RISMicroDevices/HADES-SRAM/sim/tb/tb_hades_top.sv

//-----------------------------------------------------------------------------
// HADES-SRAM — SV testbench harness (M5).
// Pin-level protocol here (dual clocks, resets, AXI4-Lite BFM, SRAM port
// drivers/monitors, MIG model wiring); test intent in sim/cpp/hades_sram_tb.cpp
// via DPI-C (expected memory, exact-latency due-cycle queues, accounting).
//
// Build variants (+define+):
//   (none)                 CSR_EN=1, SYNC    TEST=all_csr
//                          (t6,t1,t2,t3,t4,t5,t7,t9,t12,rst,t13b/c/d,t13a)
//   ASYNC                  CSR_EN=1, ASYNC   TEST=all_csr (t7/t13d walk phase)
//   CSR_STATIC             CSR_EN=0, SYNC    TEST=all_static (static,t3,t9)
//   CSR_STATIC+PARAM_OVRD  CSR_EN=0, SYNC, user P_PORT_BASE/SIZE overrides
//   SELFTEST               CSR_EN=1, SYNC + SELFTEST_EN=1, BLK=16
//                          (TEST=selftest on-chip self-test smoke; the engine
//                          is inert in every other TEST — pins pass through)
// Dedicated runs (not in all_*): TEST=t3 +MAINT_STRESS=1 (worst-case
// maintenance alignment), TEST=t14 +RD_LAT_ADD=1500 (bit5 sentinel fault),
// TEST=t8 +DROP_RD_BEAT/+DROP_RD_BEAT2/+SLVERR_RD_BEAT/+SLVERR_WR_BEAT
// (error paths), TEST=ovf +AR_STALL_LEN=8000 (request-FIFO overflow),
// TEST=t10 +T10_PER=n (long regression; +WDOG_MS raises the watchdog),
// TEST=st_full +REF_BLOCK=300 (st variant; 64-port full-load selftest under
// pessimistic maintenance blocking — the A4 board scenario).
//
// Clocks: ui_clk 300 MHz.  SYNC: port_clk derived from ui_clk by integer
// divider (same-source).  ASYNC: independent realtime generator,
// incommensurate 499.983 KHz by default; T7 adds a phase walk (~4.9 deg
// steps) and +-0.5% slow drift.
//-----------------------------------------------------------------------------
`timescale 1ns/1ps
`default_nettype none

module tb_hades_top #(
  parameter int N = 64,   // DUT active ports (regression default)
  parameter int W0 = 32,
  parameter int W1 = 32,
  parameter int W2 = 32,
  parameter int W3 = 32,
  parameter int W4 = 32,
  parameter int W5 = 32,
  parameter int W6 = 32,
  parameter int W7 = 32,
  parameter int W8 = 32,
  parameter int W9 = 32,
  parameter int W10 = 32,
  parameter int W11 = 32,
  parameter int W12 = 32,
  parameter int W13 = 32,
  parameter int W14 = 32,
  parameter int W15 = 32,
  parameter int W16 = 32,
  parameter int W17 = 32,
  parameter int W18 = 32,
  parameter int W19 = 32,
  parameter int W20 = 32,
  parameter int W21 = 32,
  parameter int W22 = 32,
  parameter int W23 = 32,
  parameter int W24 = 32,
  parameter int W25 = 32,
  parameter int W26 = 32,
  parameter int W27 = 32,
  parameter int W28 = 32,
  parameter int W29 = 32,
  parameter int W30 = 32,
  parameter int W31 = 32,
  parameter int W32 = 32,
  parameter int W33 = 32,
  parameter int W34 = 32,
  parameter int W35 = 32,
  parameter int W36 = 32,
  parameter int W37 = 32,
  parameter int W38 = 32,
  parameter int W39 = 32,
  parameter int W40 = 32,
  parameter int W41 = 32,
  parameter int W42 = 32,
  parameter int W43 = 32,
  parameter int W44 = 32,
  parameter int W45 = 32,
  parameter int W46 = 32,
  parameter int W47 = 32,
  parameter int W48 = 32,
  parameter int W49 = 32,
  parameter int W50 = 32,
  parameter int W51 = 32,
  parameter int W52 = 32,
  parameter int W53 = 32,
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
      53: return W53;
      54: return W54;
      55: return W55;
      56: return W56;
      57: return W57;
      58: return W58;
      59: return W59;
      60: return W60;
      61: return W61;
      62: return W62;
      63: return W63;
      default: return 32;
    endcase
  endfunction

  function automatic int be_of(input int p);
    case (p)
      0: return BE0_EN;
      1: return BE1_EN;
      2: return BE2_EN;
      3: return BE3_EN;
      4: return BE4_EN;
      5: return BE5_EN;
      6: return BE6_EN;
      7: return BE7_EN;
      8: return BE8_EN;
      9: return BE9_EN;
      10: return BE10_EN;
      11: return BE11_EN;
      12: return BE12_EN;
      13: return BE13_EN;
      14: return BE14_EN;
      15: return BE15_EN;
      16: return BE16_EN;
      17: return BE17_EN;
      18: return BE18_EN;
      19: return BE19_EN;
      20: return BE20_EN;
      21: return BE21_EN;
      22: return BE22_EN;
      23: return BE23_EN;
      24: return BE24_EN;
      25: return BE25_EN;
      26: return BE26_EN;
      27: return BE27_EN;
      28: return BE28_EN;
      29: return BE29_EN;
      30: return BE30_EN;
      31: return BE31_EN;
      32: return BE32_EN;
      33: return BE33_EN;
      34: return BE34_EN;
      35: return BE35_EN;
      36: return BE36_EN;
      37: return BE37_EN;
      38: return BE38_EN;
      39: return BE39_EN;
      40: return BE40_EN;
      41: return BE41_EN;
      42: return BE42_EN;
      43: return BE43_EN;
      44: return BE44_EN;
      45: return BE45_EN;
      46: return BE46_EN;
      47: return BE47_EN;
      48: return BE48_EN;
      49: return BE49_EN;
      50: return BE50_EN;
      51: return BE51_EN;
      52: return BE52_EN;
      53: return BE53_EN;
      54: return BE54_EN;
      55: return BE55_EN;
      56: return BE56_EN;
      57: return BE57_EN;
      58: return BE58_EN;
      59: return BE59_EN;
      60: return BE60_EN;
      61: return BE61_EN;
      62: return BE62_EN;
      63: return BE63_EN;
      default: return 0;
    endcase
  endfunction

  localparam logic [BASE_W-1:0] OVRD_BASE3 = 34'h1_2345_0000;
  localparam logic [31:0]       OVRD_SIZE3 = 32'h0002_0000;
  localparam logic [BASE_W-1:0] OVRD_BASE5 = 34'h0_ABCD_0000;

  function automatic logic [N_MAX*BASE_W-1:0] tb_base_flat();
    logic [N_MAX*BASE_W-1:0] v;
    v = dflt_base_flat();
`ifdef PARAM_OVRD
    v[3*BASE_W +: BASE_W] = OVRD_BASE3;
    v[5*BASE_W +: BASE_W] = OVRD_BASE5;
`endif
    return v;
  endfunction

  function automatic logic [N_MAX*32-1:0] tb_size_flat();
    logic [N_MAX*32-1:0] v;
    v = dflt_size_flat(DW_DEFAULT);
`ifdef PARAM_OVRD
    v[3*32 +: 32] = OVRD_SIZE3;
`endif
    return v;
  endfunction

  // ------------------------------------------------------------------
  // Clocks
  // ------------------------------------------------------------------
  logic ui_clk = 1'b0;
  always #(1.6666667) ui_clk = ~ui_clk;   // 300 MHz

  bit   pc_run = 1'b1;
  logic port_clk = 1'b0;

  // current gear's base half period (ns); used by the T7 phase walk/drift
  realtime gear_half_ns;
  initial gear_half_ns = 1000.034;   // 500 KHz gear (also SYNC divider base)

`ifdef ASYNC
  // independent incommensurate source: 499.983 KHz (period 2000.068 ns).
  // T7 phase walk: pc_shift_ns is a one-shot phase nudge (<= 5 deg of the
  // period per step) applied to the next half period; drift walks pc_half_ns
  // around gear_half_ns within +-0.5%.
  realtime pc_half_ns;
  realtime pc_shift_ns = 0.0;
  initial pc_half_ns = 1000.034;
  always begin : g_pclk
    realtime h;
    h = pc_half_ns + pc_shift_ns;
    pc_shift_ns = 0.0;
    #(h);
    if (pc_run) port_clk = ~port_clk;
  end
  task automatic port_clk_set_khz(input int khz);
    gear_half_ns = 500000.0 / khz;
    pc_half_ns   = gear_half_ns;
  endtask

  bit      phase_walk_en = 1'b0;
  realtime drift         = 0.0;
  int      drift_dir     = 1;
  always begin : g_walk
    repeat (3) @(posedge port_clk);
    if (phase_walk_en) begin
      pc_shift_ns = gear_half_ns * 0.049;   // ~4.9 deg step (<= 5 deg)
      if (drift_dir) drift = drift + 0.0004; else drift = drift - 0.0004;
      if (drift >  0.005) begin drift =  0.005; drift_dir = 0; end
      if (drift < -0.005) begin drift = -0.005; drift_dir = 1; end
      pc_half_ns = gear_half_ns * (1.0 + drift);
    end
  end
`else
  // SYNC: integer divider from ui_clk (same-source, like an MMCM output)
  int pc_div = 600;      // ui cycles per port period; 600 => 500 KHz
  int pc_cnt = 0;
  always @(posedge ui_clk) begin
    if (!pc_run) begin
      pc_cnt   <= 0;
      port_clk <= 1'b0;
    end else if (pc_cnt >= pc_div/2 - 1) begin
      pc_cnt   <= 0;
      port_clk <= ~port_clk;
    end else begin
      pc_cnt   <= pc_cnt + 1;
    end
  end
  task automatic port_clk_set_khz(input int khz);
    pc_div       = 300_000 / khz;
    gear_half_ns = 500000.0 / khz;
  endtask
`endif

  task automatic port_clk_stop();  begin pc_run = 1'b0; port_clk = 1'b0; end endtask
  task automatic port_clk_start(); begin pc_run = 1'b1; end endtask

  logic ui_rst_n   = 1'b0;
  logic port_rst_n = 1'b0;
  logic calib_done = 1'b0;

  // ------------------------------------------------------------------
  // DUT <-> MIG model wiring
  // ------------------------------------------------------------------
  // TB-internal packed views (runtime-indexable); the boundary assigns
  // below map them onto the DUT's flat per-port signals (v1.1.0)
  logic [N_MAX-1:0]                t_en    = '0;
  logic [N_MAX-1:0]                t_we    = '0;
  logic [N_MAX-1:0][AW_DEFAULT-1:0] t_addr  = '0;
  logic [N_MAX-1:0][511:0]         t_wdata = '0;
  logic [N_MAX-1:0][63:0]          t_be    = '1;
  logic [N_MAX-1:0][511:0]         t_rdata;
  logic [N_MAX-1:0]                t_rvalid;

  logic [15:0] s_axil_awaddr = 16'd0;
  logic        s_axil_awvalid = 1'b0;
  logic        s_axil_awready;
  logic [31:0] s_axil_wdata = 32'd0;
  logic [3:0]  s_axil_wstrb = 4'h0;
  logic        s_axil_wvalid = 1'b0;
  logic        s_axil_wready;
  logic [1:0]  s_axil_bresp;
  logic        s_axil_bvalid;
  logic        s_axil_bready = 1'b0;
  logic [15:0] s_axil_araddr = 16'd0;
  logic        s_axil_arvalid = 1'b0;
  logic        s_axil_arready;
  logic [31:0] s_axil_rdata;
  logic [1:0]  s_axil_rresp;
  logic        s_axil_rvalid;
  logic        s_axil_rready = 1'b0;

  logic        stat_calib_done, stat_ready, stat_refresh_active, stat_zq_active;
  logic [7:0]  stat_err;

  // DUT <-> model maintenance handshake
  logic        ref_req, ref_ack, zq_req, zq_ack;

  // pin-level backdoor (used in CSR_STATIC builds; tied off otherwise)
  logic                      bkp_req_t = 1'b0, bkp_we_t = 1'b0;
  logic [7:0]                bkp_port_t = 8'd0;
  logic [BASE_W-1:0]         bkp_addr_t = '0;
  logic [DW_DEFAULT-1:0]     bkp_wdata_t = '0;
  logic [DW_DEFAULT-1:0]     bkp_rdata_t;
  logic                      bkp_ack_t;

  // T14: set while fault-injected late responses are expected; gates the
  // rdata X/mismatch checks (rvalid must still assert on schedule)
  bit expect_sentinel = 1'b0;

  // DUT AXI4 master <-> model slave
  logic [3:0]         axi_awid;
  logic [AXI_ADDR_W-1:0] axi_awaddr;
  logic [7:0]         axi_awlen;
  logic [2:0]         axi_awsize;
  logic [1:0]         axi_awburst;
  logic               axi_awvalid, axi_awready;
  logic [511:0]       axi_wdata;
  logic [63:0]        axi_wstrb;
  logic               axi_wlast, axi_wvalid, axi_wready;
  logic [3:0]         axi_bid;
  logic [1:0]         axi_bresp;
  logic               axi_bvalid, axi_bready;
  logic [3:0]         axi_arid;
  logic [AXI_ADDR_W-1:0] axi_araddr;
  logic [7:0]         axi_arlen;
  logic [2:0]         axi_arsize;
  logic [1:0]         axi_arburst;
  logic               axi_arvalid, axi_arready;
  logic [3:0]         axi_rid;
  logic [511:0]       axi_rdata;
  logic [1:0]         axi_rresp;
  logic               axi_rlast, axi_rvalid, axi_rready;

  logic ui_rst;

  // flat per-port DUT signal declarations (v1.1.0)
  logic sram0_en, sram0_we;
  logic [AW_DEFAULT-1:0] sram0_addr;
  logic [W0-1:0] sram0_wdata;
  logic [63:0] sram0_be;
  logic [W0-1:0] sram0_rdata;
  logic sram0_rvalid;
  logic sram1_en, sram1_we;
  logic [AW_DEFAULT-1:0] sram1_addr;
  logic [W1-1:0] sram1_wdata;
  logic [63:0] sram1_be;
  logic [W1-1:0] sram1_rdata;
  logic sram1_rvalid;
  logic sram2_en, sram2_we;
  logic [AW_DEFAULT-1:0] sram2_addr;
  logic [W2-1:0] sram2_wdata;
  logic [63:0] sram2_be;
  logic [W2-1:0] sram2_rdata;
  logic sram2_rvalid;
  logic sram3_en, sram3_we;
  logic [AW_DEFAULT-1:0] sram3_addr;
  logic [W3-1:0] sram3_wdata;
  logic [63:0] sram3_be;
  logic [W3-1:0] sram3_rdata;
  logic sram3_rvalid;
  logic sram4_en, sram4_we;
  logic [AW_DEFAULT-1:0] sram4_addr;
  logic [W4-1:0] sram4_wdata;
  logic [63:0] sram4_be;
  logic [W4-1:0] sram4_rdata;
  logic sram4_rvalid;
  logic sram5_en, sram5_we;
  logic [AW_DEFAULT-1:0] sram5_addr;
  logic [W5-1:0] sram5_wdata;
  logic [63:0] sram5_be;
  logic [W5-1:0] sram5_rdata;
  logic sram5_rvalid;
  logic sram6_en, sram6_we;
  logic [AW_DEFAULT-1:0] sram6_addr;
  logic [W6-1:0] sram6_wdata;
  logic [63:0] sram6_be;
  logic [W6-1:0] sram6_rdata;
  logic sram6_rvalid;
  logic sram7_en, sram7_we;
  logic [AW_DEFAULT-1:0] sram7_addr;
  logic [W7-1:0] sram7_wdata;
  logic [63:0] sram7_be;
  logic [W7-1:0] sram7_rdata;
  logic sram7_rvalid;
  logic sram8_en, sram8_we;
  logic [AW_DEFAULT-1:0] sram8_addr;
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
    .sram51_be     (sram51_be),
    .sram51_rdata  (sram51_rdata),
    .sram51_rvalid (sram51_rvalid),
    .sram52_en     (sram52_en),
    .sram52_we     (sram52_we),
    .sram52_addr   (sram52_addr),
    .sram52_wdata  (sram52_wdata),
    .sram52_be     (sram52_be),
    .sram52_rdata  (sram52_rdata),
    .sram52_rvalid (sram52_rvalid),
    .sram53_en     (sram53_en),
    .sram53_we     (sram53_we),
    .sram53_addr   (sram53_addr),
    .sram53_wdata  (sram53_wdata),
    .sram53_be     (sram53_be),
    .sram53_rdata  (sram53_rdata),
    .sram53_rvalid (sram53_rvalid),
    .sram54_en     (sram54_en),
    .sram54_we     (sram54_we),
    .sram54_addr   (sram54_addr),
    .sram54_wdata  (sram54_wdata),
    .sram54_be     (sram54_be),
    .sram54_rdata  (sram54_rdata),
    .sram54_rvalid (sram54_rvalid),
    .sram55_en     (sram55_en),
    .sram55_we     (sram55_we),
    .sram55_addr   (sram55_addr),
    .sram55_wdata  (sram55_wdata),
    .sram55_be     (sram55_be),
    .sram55_rdata  (sram55_rdata),
    .sram55_rvalid (sram55_rvalid),
    .sram56_en     (sram56_en),
    .sram56_we     (sram56_we),
    .sram56_addr   (sram56_addr),
    .sram56_wdata  (sram56_wdata),
    .sram56_be     (sram56_be),
    .sram56_rdata  (sram56_rdata),
    .sram56_rvalid (sram56_rvalid),
    .sram57_en     (sram57_en),
    .sram57_we     (sram57_we),
    .sram57_addr   (sram57_addr),
    .sram57_wdata  (sram57_wdata),
    .sram57_be     (sram57_be),
    .sram57_rdata  (sram57_rdata),
    .sram57_rvalid (sram57_rvalid),
    .sram58_en     (sram58_en),
    .sram58_we     (sram58_we),
    .sram58_addr   (sram58_addr),
    .sram58_wdata  (sram58_wdata),
    .sram58_be     (sram58_be),
    .sram58_rdata  (sram58_rdata),
    .sram58_rvalid (sram58_rvalid),
    .sram59_en     (sram59_en),
    .sram59_we     (sram59_we),
    .sram59_addr   (sram59_addr),
    .sram59_wdata  (sram59_wdata),
    .sram59_be     (sram59_be),
    .sram59_rdata  (sram59_rdata),
    .sram59_rvalid (sram59_rvalid),
    .sram60_en     (sram60_en),
    .sram60_we     (sram60_we),
    .sram60_addr   (sram60_addr),
    .sram60_wdata  (sram60_wdata),
    .sram60_be     (sram60_be),
    .sram60_rdata  (sram60_rdata),
    .sram60_rvalid (sram60_rvalid),
    .sram61_en     (sram61_en),
    .sram61_we     (sram61_we),
    .sram61_addr   (sram61_addr),
    .sram61_wdata  (sram61_wdata),
    .sram61_be     (sram61_be),
    .sram61_rdata  (sram61_rdata),
    .sram61_rvalid (sram61_rvalid),
    .sram62_en     (sram62_en),
    .sram62_we     (sram62_we),
    .sram62_addr   (sram62_addr),
    .sram62_wdata  (sram62_wdata),
    .sram62_be     (sram62_be),
    .sram62_rdata  (sram62_rdata),
    .sram62_rvalid (sram62_rvalid),
    .sram63_en     (sram63_en),
    .sram63_we     (sram63_we),
    .sram63_addr   (sram63_addr),
    .sram63_wdata  (sram63_wdata),
    .sram63_be     (sram63_be),
    .sram63_rdata  (sram63_rdata),
    .sram63_rvalid (sram63_rvalid),

    .m_axi_awid     (axi_awid),
    .m_axi_awaddr   (axi_awaddr),
    .m_axi_awlen    (axi_awlen),
    .m_axi_awsize   (axi_awsize),
    .m_axi_awburst  (axi_awburst),
    .m_axi_awvalid  (axi_awvalid),
    .m_axi_awready  (axi_awready),
    .m_axi_wdata    (axi_wdata),
    .m_axi_wstrb    (axi_wstrb),
    .m_axi_wlast    (axi_wlast),
    .m_axi_wvalid   (axi_wvalid),
    .m_axi_wready   (axi_wready),
    .m_axi_bid      (axi_bid),
    .m_axi_bresp    (axi_bresp),
    .m_axi_bvalid   (axi_bvalid),
    .m_axi_bready   (axi_bready),
    .m_axi_arid     (axi_arid),
    .m_axi_araddr   (axi_araddr),
    .m_axi_arlen    (axi_arlen),
    .m_axi_arsize   (axi_arsize),
    .m_axi_arburst  (axi_arburst),
    .m_axi_arvalid  (axi_arvalid),
    .m_axi_arready  (axi_arready),
    .m_axi_rid      (axi_rid),
    .m_axi_rdata    (axi_rdata),
    .m_axi_rresp    (axi_rresp),
    .m_axi_rlast    (axi_rlast),
    .m_axi_rvalid   (axi_rvalid),
    .m_axi_rready   (axi_rready),
    .app_ref_req    (ref_req),
    .app_ref_ack    (ref_ack),
    .app_zq_req     (zq_req),
    .app_zq_ack     (zq_ack),
    .s_axil_awaddr  (s_axil_awaddr),
    .s_axil_awvalid (s_axil_awvalid),
    .s_axil_awready (s_axil_awready),
    .s_axil_wdata   (s_axil_wdata),
    .s_axil_wstrb   (s_axil_wstrb),
    .s_axil_wvalid  (s_axil_wvalid),
    .s_axil_wready  (s_axil_wready),
    .s_axil_bresp   (s_axil_bresp),
    .s_axil_bvalid  (s_axil_bvalid),
    .s_axil_bready  (s_axil_bready),
    .s_axil_araddr  (s_axil_araddr),
    .s_axil_arvalid (s_axil_arvalid),
    .s_axil_arready (s_axil_arready),
    .s_axil_rdata   (s_axil_rdata),
    .s_axil_rresp   (s_axil_rresp),
    .s_axil_rvalid  (s_axil_rvalid),
    .s_axil_rready  (s_axil_rready),
    .stat_calib_done    (stat_calib_done),
    .stat_ready         (stat_ready),
    .stat_refresh_active(stat_refresh_active),
    .stat_zq_active     (stat_zq_active),
    .stat_err           (stat_err),
    .bkp_req    (bkp_req_t),
    .bkp_we     (bkp_we_t),
    .bkp_port   (bkp_port_t),
    .bkp_addr   (bkp_addr_t),
    .bkp_wdata  (bkp_wdata_t),
    .bkp_rdata  (bkp_rdata_t),
    .bkp_ack    (bkp_ack_t)
  );

  assign ui_rst = ~ui_rst_n;

  mig_axi4_model u_mig_model (
    .aclk          (ui_clk),
    .arst          (ui_rst),
    .s_axi_awid    (axi_awid),
    .s_axi_awaddr  (axi_awaddr),
    .s_axi_awlen   (axi_awlen),
    .s_axi_awsize  (axi_awsize),
    .s_axi_awburst (axi_awburst),
    .s_axi_awvalid (axi_awvalid),
    .s_axi_awready (axi_awready),
    .s_axi_wdata   (axi_wdata),
    .s_axi_wstrb   (axi_wstrb),
    .s_axi_wlast   (axi_wlast),
    .s_axi_wvalid  (axi_wvalid),
    .s_axi_wready  (axi_wready),
    .s_axi_bid     (axi_bid),
    .s_axi_bresp   (axi_bresp),
    .s_axi_bvalid  (axi_bvalid),
    .s_axi_bready  (axi_bready),
    .s_axi_arid    (axi_arid),
    .s_axi_araddr  (axi_araddr),
    .s_axi_arlen   (axi_arlen),
    .s_axi_arsize  (axi_arsize),
    .s_axi_arburst (axi_arburst),
    .s_axi_arvalid (axi_arvalid),
    .s_axi_arready (axi_arready),
    .s_axi_rid     (axi_rid),
    .s_axi_rdata   (axi_rdata),
    .s_axi_rresp   (axi_rresp),
    .s_axi_rlast   (axi_rlast),
    .s_axi_rvalid  (axi_rvalid),
    .s_axi_rready  (axi_rready),
    .app_ref_req   (ref_req),
    .app_ref_ack   (ref_ack),
    .app_zq_req    (zq_req),
    .app_zq_ack    (zq_ack)
  );

  // ------------------------------------------------------------------
  // DPI-C imports
  // ------------------------------------------------------------------
  import "DPI-C" context function void     hades_init();
  import "DPI-C" context function void     hades_phase_init();
  import "DPI-C" context function void     hades_suspend_checks(int on);
  import "DPI-C" context function longint  hades_exp_id();
  import "DPI-C" context function longint  hades_exp_params(int is_sync, int ui_mhz,
                                                           int port_mib, int dw, int n_max);
  import "DPI-C" context function void     hades_set_port_cfg(int port, longint base, int size);
  import "DPI-C" context function void     hades_set_port_width(int port, int bits);
  import "DPI-C" context function longint  hades_exp_base(int port);
  import "DPI-C" context function int      hades_exp_size(int port);
  import "DPI-C" context function void     hades_mem_write(int port, int addr, bit [511:0] data);
  import "DPI-C" context function void     hades_mem_write_be(int port, int addr, bit [511:0] data, longint be);
  import "DPI-C" context function void     hades_read_expect(int port, longint due_cycle, int addr);
  import "DPI-C" context function void     hades_read_expect0(int port, longint due_cycle);
  import "DPI-C" context function void     hades_read_expect_late(int port, longint due_cycle);
  import "DPI-C" context function void     hades_port_edge(int port, longint cycle,
                                                           int rvalid, bit [511:0] rdata);
  import "DPI-C" context function void     hades_check_eq(string what, longint got, longint exp);
  import "DPI-C" context function void     hades_check_range(string what, longint got,
                                                             longint lo, longint hi);
  import "DPI-C" context function void     hades_fail(string msg);
  import "DPI-C" context function void     hades_log(string msg);
  import "DPI-C" context function int      hades_err_count();
  import "DPI-C" context function void     hades_report();

  // ------------------------------------------------------------------
  // portable PRNG (xorshift32) — identical stimulus on VCS and xsim
  // ------------------------------------------------------------------
  logic [31:0] rng_s = 32'h5EED_1234;

  task automatic rnd(input int unsigned lo, input int unsigned hi,
                     output int unsigned v);
    logic [31:0] x;
    begin
      x = rng_s;
      x ^= x << 13; x ^= x >> 17; x ^= x << 5;
      rng_s = x;
      v = lo + (x % (hi - lo + 1));
    end
  endtask

  // ------------------------------------------------------------------
  // AXI4-Lite master BFM (ui_clk domain)
  // ------------------------------------------------------------------
  task automatic axil_wr(input logic [15:0] a, input logic [31:0] d);
    @(posedge ui_clk);
    s_axil_awaddr  <= a;
    s_axil_awvalid <= 1'b1;
    s_axil_wdata   <= d;
    s_axil_wstrb   <= 4'hF;
    s_axil_wvalid  <= 1'b1;
    forever begin
      @(posedge ui_clk);
      if (s_axil_awready && s_axil_wready) break;
    end
    s_axil_awvalid <= 1'b0;
    s_axil_wvalid  <= 1'b0;
    s_axil_bready  <= 1'b1;
    forever begin
      @(posedge ui_clk);
      if (s_axil_bvalid) break;
    end
    s_axil_bready <= 1'b0;
  endtask

  task automatic axil_rd(input logic [15:0] a, output logic [31:0] d);
    @(posedge ui_clk);
    s_axil_araddr  <= a;
    s_axil_arvalid <= 1'b1;
    s_axil_rready  <= 1'b1;
    forever begin
      @(posedge ui_clk);
      if (s_axil_arready) break;
    end
    s_axil_arvalid <= 1'b0;
    forever begin
      @(posedge ui_clk);
      if (s_axil_rvalid) begin
        d = s_axil_rdata;
        break;
      end
    end
    s_axil_rready <= 1'b0;
  endtask

  // ------------------------------------------------------------------
  // port_clk edge counter + response monitor (exact-latency checking)
  // ------------------------------------------------------------------
  longint pcycle = 0;

  always @(posedge port_clk) begin
    #(0.001);   // 1 ps after the edge: post-NBA sample
    pcycle = pcycle + 1;
    for (int p = 0; p < N_MAX; p++) begin
      if ($isunknown(t_rvalid[p]) ||
          (!expect_sentinel && t_rvalid[p] === 1'b1 && $isunknown(t_rdata[p])))
        hades_fail($sformatf("X on port %0d outputs at pcycle %0d (rvalid=%b rdata=%h)",
                             p, pcycle, t_rvalid[p], t_rdata[p]));
      hades_port_edge(p, pcycle, (t_rvalid[p] === 1'b1) ? 1 : 0,
                      t_rdata[p]);
    end
  end

  // ------------------------------------------------------------------
  // SRAM port drivers (drive at negedge; sampled at next posedge = pcycle+1)
  // ------------------------------------------------------------------
  int cur_lat = 2;   // TB's view of the active L

  task automatic sram_write(input int port, input int addr, input bit [511:0] data);
    @(negedge port_clk);
    t_en[port]    <= 1'b1;
    t_we[port]    <= 1'b1;
    t_addr[port]  <= addr;
    t_wdata[port] <= data;
    hades_mem_write(port, addr, data);
    @(negedge port_clk);
    t_en[port]    <= 1'b0;
  endtask

  // byte-enabled write (v1.1.0): drives t_be with the word (ports with
  // BE<i>_EN=0 ignore it) and merges enabled bytes in the expected model
  task automatic sram_write_be(input int port, input int addr,
                               input bit [511:0] data, input bit [63:0] be);
    @(negedge port_clk);
    t_en[port]    <= 1'b1;
    t_we[port]    <= 1'b1;
    t_addr[port]  <= addr;
    t_wdata[port] <= data;
    t_be[port]    <= be;
    hades_mem_write_be(port, addr, data, be);
    @(negedge port_clk);
    t_en[port]    <= 1'b0;
    t_be[port]    <= '1;
  endtask

  task automatic sram_read(input int port, input int addr);
    @(negedge port_clk);
    t_en[port]    <= 1'b1;
    t_we[port]    <= 1'b0;
    t_addr[port]  <= addr;
    hades_read_expect(port, pcycle + 1 + cur_lat, addr);
    @(negedge port_clk);
    t_en[port]    <= 1'b0;
  endtask

  // fully back-to-back read burst (one read every port period)
  task automatic sram_read_burst(input int port, input int n, input int addr0);
    for (int k = 0; k < n; k++) begin
      @(negedge port_clk);
      t_en[port]   <= 1'b1;
      t_we[port]   <= 1'b0;
      t_addr[port] <= addr0 + k;
      hades_read_expect(port, pcycle + 1 + cur_lat, addr0 + k);
    end
    @(negedge port_clk);
    t_en[port] <= 1'b0;
  endtask

  // fully back-to-back write burst
  task automatic sram_write_burst(input int port, input int n, input int addr0,
                                  input bit [511:0] data0);
    for (int k = 0; k < n; k++) begin
      @(negedge port_clk);
      t_en[port]   <= 1'b1;
      t_we[port]   <= 1'b1;
      t_addr[port] <= addr0 + k;
      t_wdata[port] <= data0 + k;
      hades_mem_write(port, addr0 + k, data0 + k);
    end
    @(negedge port_clk);
    t_en[port] <= 1'b0;
  endtask

  // read to an illegal address: synthetic zero response, still on schedule
  task automatic sram_read_illegal(input int port, input int addr);
    @(negedge port_clk);
    t_en[port]    <= 1'b1;
    t_we[port]    <= 1'b0;
    t_addr[port]  <= addr;
    hades_read_expect0(port, pcycle + 1 + cur_lat);
    @(negedge port_clk);
    t_en[port]    <= 1'b0;
  endtask

  // let all outstanding reads release
  task automatic drain();
    repeat (5) @(negedge port_clk);
  endtask

  // ------------------------------------------------------------------
  // Reset.  Resets must be held for >= 3 port_clk periods: the port domain
  // (FIFOs, shaper) is synchronous to the slow clock, and the afifo's two
  // sides must reset together — a ui-only pulse would corrupt the Gray
  // pointers.  (The CSR SOFT_RESET instead stretches into the port domain
  // by design; see the top level.)  calib_done drops (the TB models the
  // MIG recalibrating across a system reset).
  // ------------------------------------------------------------------
  task automatic do_reset();
    begin
      ui_rst_n   = 1'b0;
      port_rst_n = 1'b0;
      calib_done = 1'b0;
      repeat (3) @(posedge port_clk);
      ui_rst_n   = 1'b1;
      port_rst_n = 1'b1;
      repeat (10) @(posedge ui_clk);
    end
  endtask

  // Default flat address map for all ports.  T6 writes a custom map and T1
  // shrinks PORT_SIZE for error tests — every traffic phase must start from
  // the default flat map.
  task automatic csr_default_map();
    begin
      for (int p = 0; p < N_MAX; p++) begin
        axil_wr(CSR_PORT_SEL, 32'(p));
        axil_wr(CSR_PORT_BASE, 32'(p * 32'h0004_0000));  // i * 2^18 beats
        axil_wr(CSR_PORT_BASE_HI, 32'd0);
        axil_wr(CSR_PORT_SIZE, 32'h0040_0000);           // 16 MiB in DW32 words
      end
    end
  endtask

  // CSR helper: program L and enable mask, wait for ready.
  // The frequency monitor must observe a running, legal port_clk first
  // (spec init sequence: check MEAS_PERIOD before ENABLE; 4-period average
  // is valid after 5 edges).  n_active programs CFG_PORTS (arbiter
  // slot-table extent).
  task automatic csr_enable(input int lat, input longint en_mask,
                            input int n_active = N_MAX);
    logic [31:0] rd;
    begin
      axil_wr(CSR_CTRL, 32'h0);
      axil_wr(CSR_CFG_LATENCY, 32'(lat));
      axil_wr(CSR_PORT_EN_LO, 32'(en_mask));
      axil_wr(CSR_PORT_EN_HI, 32'(en_mask >> 32));
      axil_wr(CSR_CFG_PORTS, 32'(n_active));
      csr_default_map();
      repeat (6) @(posedge port_clk);   // let freq_mon measure the clock
      axil_wr(CSR_CTRL, 32'h1);
      // poll READY: after a SOFT_RESET the port-domain reset stretch gates
      // ENABLE for ~9.4k ui_clk cycles; each poll is ~10 cycles
      for (int t = 0; t < 2500; t++) begin
        axil_rd(CSR_STATUS, rd);
        if ((rd & 32'h3) == 32'h3) break;
      end
      hades_check_eq("STATUS ready after ENABLE", rd & 32'h3, 32'h3);
      cur_lat = lat;
    end
  endtask

  // ------------------------------------------------------------------
  // T6 basic (CSR_EN=1)
  // ------------------------------------------------------------------
  task automatic test_t6_csr();
    logic [31:0] rd;
    longint      b;
    int unsigned s;
    begin
      hades_log("--- T6 basic: CSR flow ---");

      axil_rd(CSR_ID, rd);
      hades_check_eq("ID", rd, hades_exp_id());
      axil_rd(CSR_PARAMS, rd);
      hades_check_eq("PARAMS", rd, hades_exp_params(TB_SYNC ? 1 : 0, UI_CLK_MHZ,
                                                    PORT_MB_DEFAULT, DW_DEFAULT, N_MAX));

      // ENABLE rejected while calib_done=0
      axil_wr(CSR_CTRL, 32'h1);
      axil_rd(CSR_CTRL, rd);
      hades_check_eq("ENABLE reject (no calib)", rd, 0);
      axil_rd(CSR_ERR_STATUS, rd);
      hades_check_eq("ERR_STATUS.bit4 (no calib)", rd, 32'h10);
      axil_wr(CSR_ERR_STATUS, 32'h10);
      axil_rd(CSR_ERR_STATUS, rd);
      hades_check_eq("ERR_STATUS W1C", rd, 0);
      calib_done = 1'b1;
      repeat (4) @(posedge ui_clk);

      // indexed window: program + readback all 64 ports
      for (int p = 0; p < N_MAX; p++) begin
        b = p * 64'h0100_0000 + 64'h0000_4000;
        if (p == 5) b = (64'h2 << 32) | 64'h1234_5678;
        s = 32'h0001_0000 + p;
        hades_set_port_cfg(p, b, s);
        axil_wr(CSR_PORT_SEL, p);
        axil_wr(CSR_PORT_BASE, 32'(b));
        axil_wr(CSR_PORT_BASE_HI, 32'(b >> 32));
        axil_wr(CSR_PORT_SIZE, s);
      end
      for (int p = 0; p < N_MAX; p++) begin
        axil_wr(CSR_PORT_SEL, p);
        axil_rd(CSR_PORT_BASE, rd);
        hades_check_eq($sformatf("PORT_BASE[%0d]", p), rd, hades_exp_base(p) & 64'hFFFF_FFFF);
        axil_rd(CSR_PORT_BASE_HI, rd);
        hades_check_eq($sformatf("PORT_BASE_HI[%0d]", p), rd, (hades_exp_base(p) >> 32) & 64'h3);
        axil_rd(CSR_PORT_SIZE, rd);
        hades_check_eq($sformatf("PORT_SIZE[%0d]", p), rd, hades_exp_size(p) & 64'hFFFF_FFFF);
      end

      // out-of-range PORT_SEL
      axil_wr(CSR_PORT_SEL, 32'd200);
      axil_rd(CSR_PORT_BASE, rd);
      hades_check_eq("PORT_SEL oob read 0", rd, 0);
      axil_wr(CSR_PORT_BASE, 32'hFFFF_FFFF);
      axil_wr(CSR_PORT_SEL, 32'd0);
      axil_rd(CSR_PORT_BASE, rd);
      hades_check_eq("oob write ignored", rd, hades_exp_base(0) & 64'hFFFF_FFFF);

      // CFG_LATENCY legal/illegal
      axil_wr(CSR_CFG_LATENCY, 32'd1);
      axil_rd(CSR_CFG_LATENCY, rd);
      hades_check_eq("CFG_LATENCY=1", rd, 1);
      axil_wr(CSR_CFG_LATENCY, 32'd3);
      axil_rd(CSR_CFG_LATENCY, rd);
      hades_check_eq("CFG_LATENCY illegal ignored", rd, 1);
      axil_wr(CSR_CFG_LATENCY, 32'd2);
      axil_rd(CSR_CFG_LATENCY, rd);
      hades_check_eq("CFG_LATENCY=2", rd, 2);

      axil_wr(CSR_PORT_EN_LO, 32'hDEAD_BEEF);
      axil_rd(CSR_PORT_EN_LO, rd);
      hades_check_eq("PORT_EN_LO", rd, 32'hDEAD_BEEF);
      axil_wr(CSR_PORT_EN_HI, 32'h0BAD_F00D);
      axil_rd(CSR_PORT_EN_HI, rd);
      hades_check_eq("PORT_EN_HI", rd, 32'h0BAD_F00D);
      axil_wr(CSR_CFG_PORTS, 32'd64);
      axil_rd(CSR_CFG_PORTS, rd);
      hades_check_eq("CFG_PORTS", rd, 64);

      // MEAS_PERIOD: SYNC divider => exactly 600; ASYNC => incommensurate
      repeat (6) @(posedge port_clk);
      axil_rd(CSR_MEAS_PERIOD, rd);
`ifdef ASYNC
      hades_check_range("MEAS_PERIOD @~500KHz", rd, 595, 605);
`else
      hades_check_eq("MEAS_PERIOD @500KHz", rd, 600);
`endif

      // ENABLE -> READY; SOFT_RESET
      axil_wr(CSR_CTRL, 32'h1);
      axil_rd(CSR_CTRL, rd);
      hades_check_eq("ENABLE set", rd, 1);
      axil_rd(CSR_STATUS, rd);
      hades_check_eq("STATUS calib+ready", rd, 32'h3);
      axil_wr(CSR_CTRL, 32'h2);
      axil_rd(CSR_CTRL, rd);
      hades_check_eq("SOFT_RESET clears enable", rd, 0);
      axil_rd(CSR_STATUS, rd);
      hades_check_eq("SOFT_RESET ready=0", rd, 32'h1);
      axil_rd(CSR_CFG_PORTS, rd);
      hades_check_eq("config retained", rd, 64);

      // clock stop / restart interlock
      port_clk_stop();
      #60_000;
      axil_wr(CSR_CTRL, 32'h1);
      axil_rd(CSR_CTRL, rd);
      hades_check_eq("ENABLE reject (clk stopped)", rd, 0);
      axil_rd(CSR_ERR_STATUS, rd);
      hades_check_eq("ERR_STATUS.bit4 (clk stopped)", rd, 32'h10);
      axil_wr(CSR_ERR_STATUS, 32'h10);
      port_clk_start();
      #20_000;
      axil_wr(CSR_CTRL, 32'h1);
      axil_rd(CSR_CTRL, rd);
      hades_check_eq("ENABLE after clk restart", rd, 1);
      axil_wr(CSR_CTRL, 32'h0);

      // over-frequency interlock
      port_clk_set_khz(2000);
      #10_000;
      axil_wr(CSR_CTRL, 32'h1);
      axil_rd(CSR_CTRL, rd);
      hades_check_eq("ENABLE reject (over-freq)", rd, 0);
      axil_rd(CSR_ERR_STATUS, rd);
      hades_check_eq("ERR_STATUS.bit4 (over-freq)", rd, 32'h10);
      axil_wr(CSR_ERR_STATUS, 32'h10);
      port_clk_set_khz(500);
      #20_000;
      axil_wr(CSR_CTRL, 32'h1);
      axil_rd(CSR_CTRL, rd);
      hades_check_eq("ENABLE after freq restore", rd, 1);
      axil_wr(CSR_CTRL, 32'h0);
    end
  endtask

  // ------------------------------------------------------------------
  // T1: single-port random read/write, 100% data correctness
  // ------------------------------------------------------------------
  task automatic test_t1(input int n_ops);
    int unsigned addr;
    int unsigned data;
    int unsigned we_u;
    logic [31:0] rd;
    begin
      hades_log($sformatf("--- T1: single-port random R/W, %0d ops ---", n_ops));
      calib_done = 1'b1;
      csr_enable(2, 64'h1);   // port 0, L=2

      for (int k = 0; k < n_ops; k++) begin
        int unsigned gap;
        rnd(0, (1 << 22) - 1, addr);
        rnd(0, 32'hFFFF_FFFF, data);
        rnd(0, 1, we_u);
        if (we_u == 1) sram_write(0, addr, data);
        else           sram_read(0, addr);
        rnd(0, 3, gap);
        if (gap == 0) @(negedge port_clk);   // random idle gap
      end
      drain();

      // illegal-address read: shrink port 0's size, then read beyond it
      // (synthetic zero response on schedule + ERR_STATUS.bit0)
      axil_wr(CSR_PORT_SEL, 32'd0);
      axil_wr(CSR_PORT_SIZE, 32'h0000_1000);
      sram_read_illegal(0, 32'h0000_2000);
      drain();
      axil_rd(CSR_ERR_STATUS, rd);
      hades_check_eq("ERR_STATUS.bit0 (illegal addr)", rd & 32'h1, 32'h1);
      axil_rd(CSR_ERR_ADDR, rd);
      hades_check_eq("ERR_ADDR = port0:0x2000", rd, 32'h0000_2000);
      axil_wr(CSR_ERR_STATUS, 32'h1);   // W1C
      axil_rd(CSR_ERR_STATUS, rd);
      hades_check_eq("ERR_STATUS cleared", rd, 32'h0);

      // per-port stats sanity
      axil_wr(CSR_PORT_SEL, 32'd0);
      axil_rd(CSR_PORT_STAT_ERR, rd);
      hades_check_eq("port0 err count = 1 (illegal)", rd, 1);
      axil_wr(CSR_PORT_STAT_ERR, 32'h1);  // W1C clear
      axil_rd(CSR_PORT_STAT_ERR, rd);
      hades_check_eq("port0 err cleared", rd, 0);

      axil_wr(CSR_PORT_SIZE, 32'h0040_0000);   // restore default 16 MiB
      axil_wr(CSR_CTRL, 32'h0);
    end
  endtask

  // ------------------------------------------------------------------
  // T2: latency exactness — rvalid exactly at request+L port edges.
  // L=2 and L=1, back-to-back bursts and gapped traffic.
  // ------------------------------------------------------------------
  task automatic test_t2();
    begin
      hades_log("--- T2: latency exactness, L=2 and L=1 ---");
      calib_done = 1'b1;

      for (int lat = 2; lat >= 1; lat--) begin
        csr_enable(lat, 64'h3);          // ports 0 and 1
        // seed memory then fully back-to-back burst reads
        sram_write_burst(0, 64, 32'h1000, 32'hA500_0000);
        sram_write_burst(1, 64, 32'h2000, 32'h5A00_0000);
        drain();
        sram_read_burst(0, 64, 32'h1000);
        drain();
        // two ports concurrently: writes then reads, interleaved in time
        fork
          begin
            sram_write_burst(0, 32, 32'h4000, 32'hC000_0000);
            sram_read_burst(0, 32, 32'h4000);
          end
          begin
            sram_write_burst(1, 32, 32'h5000, 32'h0300_0000);
            sram_read_burst(1, 32, 32'h5000);
          end
        join
        drain();
        // RAW: write then read same address on adjacent cycles
        @(negedge port_clk);
        t_en[0] <= 1'b1; t_we[0] <= 1'b1; t_addr[0] <= 32'h777; t_wdata[0] <= 32'hDEAD_1234;
        hades_mem_write(0, 32'h777, 32'hDEAD_1234);
        @(negedge port_clk);
        t_en[0] <= 1'b1; t_we[0] <= 1'b0; t_addr[0] <= 32'h777;
        hades_read_expect(0, pcycle + 1 + cur_lat, 32'h777);
        @(negedge port_clk);
        t_en[0] <= 1'b0;
        drain();
      end
      axil_wr(CSR_CTRL, 32'h0);
    end
  endtask

  // ------------------------------------------------------------------
  // T3: maintenance stress — worst refresh+ZQCS+periodic-read combination,
  // repeating the full T2 content.  Maintenance cadence is shrunk so the
  // window is exercised every target period (refresh due every period,
  // ZQCS every 4 periods); the MAINT_STRESS plusarg additionally forces a
  // PHY periodic read into every refresh window (model side).
  // Determinism proof: ERR_STATUS stays 0 (bit5 sentinel silent) and the
  // refresh rate tracks CFG_REFRESH_DIV (A6 rehearsal).
  // ------------------------------------------------------------------
  task automatic test_t3();
    logic [31:0] rd;
    logic [31:0] refc0, refc1;
    longint      w0, w1;
    begin
      hades_log("--- T3: maintenance stress, T2 content ---");
      calib_done = 1'b1;
`ifdef CSR_STATIC
      // static variant: fixed P_REFRESH_DIV=2100 / P_ZQ_DIV=32000 / L=2
      #10_000;
      fork
        begin
          sram_write_burst(0, 64, 32'h9000, 32'h3C00_0000);
          sram_read_burst(0, 64, 32'h9000);
        end
        begin
          sram_write_burst(1, 64, 32'hA000, 32'hC300_0000);
          sram_read_burst(1, 64, 32'hA000);
        end
      join
      drain();
      hades_check_eq("T3 static: stat_err clean", stat_err, 0);
`else
      axil_wr(CSR_CTRL, 32'h0);
      axil_wr(CSR_CFG_REFRESH_DIV, 32'd600);   // one refresh due per window
      axil_wr(CSR_CFG_ZQ_DIV, 32'd4);          // ZQCS every 4 windows
      test_t2();                               // spec: repeat T2 under stress

      // refresh rate over 100 windows (enabled, no traffic)
      csr_enable(2, 64'h3);
      axil_rd(CSR_STAT_REFCNT, refc0);
      w0 = pcycle;
      repeat (100) @(posedge port_clk);
      axil_rd(CSR_STAT_REFCNT, refc1);
      w1 = pcycle;
      hades_check_range("T3 STAT_REFCNT rate (~1/window)",
                        refc1 - refc0, (w1 - w0) * 95 / 100, (w1 - w0) * 105 / 100 + 2);

      axil_rd(CSR_ERR_STATUS, rd);
      hades_check_eq("T3: ERR_STATUS clean under worst maintenance", rd & 32'h3F, 0);
      axil_wr(CSR_CFG_REFRESH_DIV, 32'd2100);  // restore defaults
      axil_wr(CSR_CFG_ZQ_DIV, 32'd32000);
      axil_wr(CSR_CTRL, 32'h0);
`endif
    end
  endtask

  // ------------------------------------------------------------------
  // T14: response-window sentinel — the model's +RD_LAT_ADD stretches every
  // backend read past the L-cycle contract; each release must still assert
  // rvalid on schedule (data don't-care) and ERR_STATUS.bit5 must set.
  // Dedicated run only (not part of all_csr/all_static).
  // ------------------------------------------------------------------
  task automatic test_t14();
    logic [31:0] rd;
    int unsigned lat_add;
    begin
      hades_log("--- T14: response-window sentinel fault injection ---");
      if (!$value$plusargs("RD_LAT_ADD=%d", lat_add) || lat_add == 0) begin
        hades_log("T14 skipped: needs +RD_LAT_ADD=<n> model stretch");
        return;
      end
      calib_done = 1'b1;
`ifdef CSR_STATIC
      #10_000;   // static auto-enable, P_L=2
      expect_sentinel = 1;
      sram_write(0, 32'h300, 32'h5AFE_0001);
      for (int k = 0; k < 3; k++) begin
        @(negedge port_clk);
        t_en[0] <= 1'b1; t_we[0] <= 1'b0; t_addr[0] <= 32'h300 + k;
        hades_read_expect_late(0, pcycle + 1 + 2);
        @(negedge port_clk);
        t_en[0] <= 1'b0;
        @(negedge port_clk);
      end
      drain();
      expect_sentinel = 0;
      // L=2 + the 768-cycle backend-timeout backstop: the synthetic zero
      // lands before the release edge, so a dead backend surfaces as bit1
      // (timeout), not bit5.  The sentinel is reachable at L=1 (CSR runs).
      hades_check_eq("T14 static: timeout backstop stat_err[1]", stat_err[1], 1);
      hades_check_eq("T14 static: sentinel bit5 stays 0", stat_err[5], 0);
`else
      csr_enable(1, 64'h1);   // L=1: tightest response window
      expect_sentinel = 1;
      sram_write(0, 32'h300, 32'h5AFE_0001);
      for (int k = 0; k < 3; k++) begin
        @(negedge port_clk);
        t_en[0] <= 1'b1; t_we[0] <= 1'b0; t_addr[0] <= 32'h300 + k;
        hades_read_expect_late(0, pcycle + 1 + cur_lat);
        @(negedge port_clk);
        t_en[0] <= 1'b0;
        @(negedge port_clk);
      end
      drain();
      expect_sentinel = 0;
      axil_rd(CSR_ERR_STATUS, rd);
      hades_check_eq("T14: ERR_STATUS.bit5 sentinel set", rd & 32'h20, 32'h20);
      hades_check_eq("T14: first-error port = 0", (rd >> 8) & 32'hFF, 0);
      axil_wr(CSR_ERR_STATUS, 32'h3F);   // W1C all (timeout bit1 also fired)
      axil_rd(CSR_ERR_STATUS, rd);
      hades_check_eq("T14: error bits W1C clear", rd & 32'h3F, 0);
      axil_wr(CSR_CTRL, 32'h0);
`endif
    end
  endtask

  // ------------------------------------------------------------------
  // T8: error paths.  Needs the model fault knobs (+DROP_RD_BEAT /
  //  +SLVERR_RD_BEAT / +SLVERR_WR_BEAT); skipped without them.  Fixed
  //  target addresses, so the beats are known at launch:
  //    timeout    : port 0 word 0x77777 -> beat 0x07777
  //    SLVERR rd  : port 1 word 0x05555 -> beat 0x40555
  //    SLVERR wr  : port 0 word 0x09999 -> beat 0x00999
  //  Criteria: right ERR_STATUS/stat_err bits with the right port, the
  //  faulted access still completes (synthetic zero on schedule for the
  //  timeout, real data with SLVERR status), and traffic continues clean
  //  afterwards (no hang).
  // ------------------------------------------------------------------
  task automatic test_t8();
    logic [31:0] rd;
    longint unsigned kn_drop, kn_slvrd, kn_slvwr, kn_drop2;
    begin
      hades_log("--- T8: error paths (illegal / timeout / SLVERR) ---");
      if (!($value$plusargs("DROP_RD_BEAT=%h", kn_drop)
            && $value$plusargs("DROP_RD_BEAT2=%h", kn_drop2)
            && $value$plusargs("SLVERR_RD_BEAT=%h", kn_slvrd)
            && $value$plusargs("SLVERR_WR_BEAT=%h", kn_slvwr))) begin
        hades_log("T8 skipped: needs +DROP_RD_BEAT/+DROP_RD_BEAT2/+SLVERR_RD_BEAT/+SLVERR_WR_BEAT");
        return;
      end
      calib_done = 1'b1;
`ifdef CSR_STATIC
      #10_000;   // auto-enable (P_L=2)
      cur_lat = 2;
`ifdef PARAM_OVRD
      // illegal: port 3 is shrunk to 128 KiW by the override — read beyond
      // it.  (In the plain static map every 22-bit address is legal by
      // construction, so bit0 is exercised here and in the CSR variants.)
      @(negedge port_clk);
      t_en[3] <= 1'b1; t_we[3] <= 1'b0; t_addr[3] <= 32'h0002_0000;
      hades_read_expect0(3, pcycle + 1 + cur_lat);
      @(negedge port_clk);
      t_en[3] <= 1'b0;
      drain();
`endif
      // timeout: the dropped read completes as scheduled zeros
      @(negedge port_clk);
      t_en[0] <= 1'b1; t_we[0] <= 1'b0; t_addr[0] <= 32'h0007_7777;
      hades_read_expect0(0, pcycle + 1 + cur_lat);
      @(negedge port_clk);
      t_en[0] <= 1'b0;
      drain();
      // SLVERR read (real data + error flag) and SLVERR write (applied,
      // then flagged on B)
      sram_write(1, 32'h5555, 32'hABCD_0001);
      drain();
      sram_read(1, 32'h5555);
      sram_write(0, 32'h9999, 32'h0BAD_0BAD);
      drain();
      sram_read(0, 32'h9999);   // written data survives the SLVERR flag
      drain();
`ifdef PARAM_OVRD
      hades_check_eq("T8 static: stat_err bits 0/1/3", stat_err, 8'h0B);
`else
      // plain static map: bit0 unreachable (every 22-bit address legal)
      hades_check_eq("T8 static: stat_err bits 1/3", stat_err, 8'h0A);
`endif
      // no hang: clean burst afterwards (scoreboard validates)
      sram_write_burst(0, 32, 32'h4000, 32'h1234_0000);
      sram_read_burst(0, 32, 32'h4000);
      drain();
`else
      csr_enable(2, 64'hF, 4);

      // (1) backdoor read of the drop2 beat: the backend timeout completes
      // it with zeros; bit1 sets with the backdoor marker port 0xFF (done
      // FIRST so the first-error latch is clean)
      begin
        logic [31:0] bst, bd;
        bkp_rd(3, 32'h0000_ACE0, bd, bst);
        hades_check_eq("T8: bkp timeout completes err-free", bst & 32'h7, 32'h2);
        hades_check_eq("T8: bkp timeout data = 0", bd, 0);
      end
      axil_rd(CSR_ERR_STATUS, rd);
      hades_check_eq("T8: bit1 set (backdoor timeout)", (rd >> 1) & 32'h1, 32'h1);
      hades_check_eq("T8: backdoor timeout port = 0xFF", (rd >> 8) & 32'hFF, 32'hFF);

      // (2) illegal read: shrink port 0, read beyond it (synthetic zero).
      // bit0 now sets ALONGSIDE bit1 -> first-error info must not change
      axil_wr(CSR_PORT_SEL, 32'd0);
      axil_wr(CSR_PORT_SIZE, 32'h0000_1000);
      sram_read_illegal(0, 32'h0000_2000);
      drain();
      axil_rd(CSR_ERR_STATUS, rd);
      hades_check_eq("T8: bit0 illegal set", rd & 32'h1, 32'h1);
      hades_check_eq("T8: first-error port stays 0xFF", (rd >> 8) & 32'hFF, 32'hFF);

      // (2b) illegal WRITE: discarded silently (posted), same bit0
      @(negedge port_clk);
      t_en[0] <= 1'b1; t_we[0] <= 1'b1; t_addr[0] <= 32'h0000_2000;
      t_wdata[0] <= 32'hBAD5_0000;
      @(negedge port_clk);
      t_en[0] <= 1'b0;
      drain();

      // partial W1C: bits 0+1 set; clearing only bit0 must leave bit1
      axil_wr(CSR_ERR_STATUS, 32'h1);
      axil_rd(CSR_ERR_STATUS, rd);
      hades_check_eq("T8: partial W1C keeps bit1", rd & 32'h3, 32'h2);
      axil_wr(CSR_ERR_STATUS, 32'h3F);
      csr_default_map();                  // restore port 0 size

      // (3) backend timeout on a port: the dropped read completes as
      // scheduled zeros (timeout 768 < L=2 release at 1200 -> no sentinel)
      sram_write(0, 32'h0007_7777, 32'h1234_5678);
      @(negedge port_clk);
      t_en[0] <= 1'b1; t_we[0] <= 1'b0; t_addr[0] <= 32'h0007_7777;
      hades_read_expect0(0, pcycle + 1 + cur_lat);
      @(negedge port_clk);
      t_en[0] <= 1'b0;
      drain();
      axil_rd(CSR_ERR_STATUS, rd);
      hades_check_eq("T8: bit1 timeout set", (rd >> 1) & 32'h1, 32'h1);
      hades_check_eq("T8: timeout port = 0", (rd >> 8) & 32'hFF, 0);
      axil_wr(CSR_ERR_STATUS, 32'h3F);

      // (4) SLVERR read: real data returned, bit3 flagged, port 1
      sram_write(1, 32'h5555, 32'hABCD_0001);
      drain();
      sram_read(1, 32'h5555);
      drain();
      // (5) SLVERR write: applied to memory, flagged on B; readback clean
      sram_write(0, 32'h9999, 32'h0BAD_0BAD);
      drain();
      sram_read(0, 32'h9999);
      drain();
      axil_rd(CSR_ERR_STATUS, rd);
      hades_check_eq("T8: bit3 SLVERR set", (rd >> 3) & 32'h1, 32'h1);
      axil_wr(CSR_ERR_STATUS, 32'h3F);

      // (6) no hang: clean burst traffic, no residual errors
      sram_write_burst(0, 32, 32'h4000, 32'h1234_0000);
      sram_read_burst(0, 32, 32'h4000);
      drain();
      axil_rd(CSR_ERR_STATUS, rd);
      hades_check_eq("T8: clean after faults", rd & 32'h3F, 0);
      axil_wr(CSR_CTRL, 32'h0);
`endif
    end
  endtask

`ifndef CSR_STATIC
  // ------------------------------------------------------------------
  // OVF: port request-FIFO overflow (ERR_STATUS.bit2, the "dropped request"
  // sentinel).  With the model's AR channel stalled (+AR_STALL_LEN), a
  // back-to-back read burst overruns the depth-8 request FIFO.  All reads
  // still release on schedule (sentinel fires too — fault expected); the
  // documented recovery is SOFT_RESET, verified with clean traffic after.
  // Dedicated run only (not part of all_csr).
  // ------------------------------------------------------------------
  task automatic test_ovf();
    logic [31:0] rd;
    int unsigned stall_len;
    begin
      hades_log("--- OVF: port request-FIFO overflow (bit2) ---");
      if (!$value$plusargs("AR_STALL_LEN=%d", stall_len) || stall_len < 8000) begin
        hades_log("OVF skipped: needs +AR_STALL_LEN>=8000");
        return;
      end
      calib_done = 1'b1;
      csr_enable(1, 64'h1, 1);
      for (int k = 0; k < 12; k++) begin
        @(negedge port_clk);
        t_en[0] <= 1'b1; t_we[0] <= 1'b0; t_addr[0] <= 32'h800 + 32'(k);
        hades_read_expect_late(0, pcycle + 1 + cur_lat);  // data don't-care
      end
      @(negedge port_clk);
      t_en[0] <= 1'b0;
      drain();
      axil_rd(CSR_ERR_STATUS, rd);
      hades_check_eq("OVF: bit2 dropped-request set", (rd >> 2) & 32'h1, 32'h1);
      // documented recovery: SOFT_RESET, re-init, clean traffic
      axil_wr(CSR_CTRL, 32'h2);
      repeat (20) @(posedge port_clk);
      csr_enable(1, 64'h1, 1);
      sram_write_burst(0, 16, 32'h9000, 32'hCAFE_1000);
      sram_read_burst(0, 16, 32'h9000);
      drain();
      axil_rd(CSR_ERR_STATUS, rd);
      hades_check_eq("OVF: clean after SOFT_RESET", rd & 32'h3F, 0);
      axil_wr(CSR_CTRL, 32'h0);
    end
  endtask
`endif

  // ------------------------------------------------------------------
  // Backdoor access helpers (CSR register channel / static pin channel)
  // ------------------------------------------------------------------
`ifndef CSR_STATIC
  task automatic bkp_wr(input int port, input int unsigned addr,
                        input int unsigned d, output logic [31:0] st);
    begin
      axil_wr(CSR_BKP_PORT, 32'(port));
      axil_wr(CSR_BKP_ADDR, addr);
      axil_wr(CSR_BKP_ADDR_HI, 32'd0);
      axil_wr(CSR_BKP_WDATA, d);
      axil_wr(CSR_BKP_CMD, 32'h1);
      st = 32'h0;
      for (int t = 0; t < 400; t++) begin
        axil_rd(CSR_BKP_STATUS, st);
        if (st[1]) break;
      end
      hades_check_eq("bkp_wr done seen", st & 32'h2, 32'h2);
    end
  endtask

  task automatic bkp_rd(input int port, input int unsigned addr,
                        output logic [31:0] d, output logic [31:0] st);
    begin
      axil_wr(CSR_BKP_PORT, 32'(port));
      axil_wr(CSR_BKP_ADDR, addr);
      axil_wr(CSR_BKP_ADDR_HI, 32'd0);
      axil_wr(CSR_BKP_CMD, 32'h2);
      st = 32'h0;
      for (int t = 0; t < 400; t++) begin
        axil_rd(CSR_BKP_STATUS, st);
        if (st[1]) break;
      end
      hades_check_eq("bkp_rd done seen", st & 32'h2, 32'h2);
      axil_rd(CSR_BKP_RDATA, d);
    end
  endtask
`else
  task automatic bkp_pin(input bit we, input int port, input int unsigned addr,
                         input int unsigned wd, output logic [31:0] rd);
    begin
      @(posedge ui_clk);
      bkp_port_t  <= 8'(port);
      bkp_addr_t  <= BASE_W'(addr);
      bkp_wdata_t <= wd;
      bkp_we_t    <= we;
      bkp_req_t   <= 1'b1;
      forever begin
        @(posedge ui_clk);
        if (bkp_ack_t) break;
      end
      @(posedge ui_clk);
      bkp_req_t <= 1'b0;
      rd = bkp_rdata_t;
      repeat (4) @(posedge ui_clk);   // let the engine return to idle
    end
  endtask
`endif

  // ------------------------------------------------------------------
  // T4 driver: one pseudo-random access per enabled port per target period
  // (en held 1 across the run).  Single driver process with per-port
  // xorshift state -> identical stimulus on VCS and xsim.  amask caps the
  // random address (the PARAM_OVRD build shrinks port 3 to 128 KiW).
  // ------------------------------------------------------------------
  task automatic t4_run(input int n_ports, input int n_per,
                        input int unsigned amask = (32'h1 << 22) - 1);
    int unsigned rs[N_MAX];
    int unsigned a, d, w;
    begin
      for (int p = 0; p < n_ports; p++)
        rs[p] = (32'h9E37_79B9 ^ (32'(p) * 32'h0101_0101)) | 32'h1;
      for (int k = 0; k < n_per; k++) begin
        @(negedge port_clk);
        for (int p = 0; p < n_ports; p++) begin
          rs[p] ^= rs[p] << 13; rs[p] ^= rs[p] >> 17; rs[p] ^= rs[p] << 5;
          a = rs[p] & amask;
          rs[p] ^= rs[p] << 13; rs[p] ^= rs[p] >> 17; rs[p] ^= rs[p] << 5;
          d = rs[p];
          rs[p] ^= rs[p] << 13; rs[p] ^= rs[p] >> 17; rs[p] ^= rs[p] << 5;
          w = rs[p] & 32'h1;
          t_en[p]    <= 1'b1;
          t_we[p]    <= 1'(w[0]);
          t_addr[p]  <= a;
          t_wdata[p] <= d;
          if (w[0]) hades_mem_write(p, a, d);
          else      hades_read_expect(p, pcycle + 1 + cur_lat, a);
        end
      end
      @(negedge port_clk);
      for (int p = 0; p < n_ports; p++) t_en[p] <= 1'b0;
    end
  endtask

  // ------------------------------------------------------------------
  // T4: full-port-load concurrency — all enabled ports access every period;
  // data correct, per-port latency exact (scoreboard), ERR_STATUS.bit2 == 0.
  // Gears 64/32/16/8 via CFG_PORTS + PORT_EN; plus L=1 at full load.
  // ------------------------------------------------------------------
  task automatic test_t4();
    logic [31:0] rd;
    int          k;
    begin
      hades_log("--- T4: full-load concurrency, gears 64/32/16/8 + L=1 ---");
      calib_done = 1'b1;
      for (int g = 0; g < 4; g++) begin
        k = 64 >> g;
        csr_enable(2, {64{1'b1}} >> (64 - k), k);
        t4_run(k, 32);
        drain();
        axil_rd(CSR_ERR_STATUS, rd);
        hades_check_eq($sformatf("T4 gear N=%0d: ERR_STATUS clean", k),
                       rd & 32'h3F, 0);
      end
      csr_enable(1, {64{1'b1}}, 64);   // L=1 at full load
      t4_run(64, 32);
      drain();
      axil_rd(CSR_ERR_STATUS, rd);
      hades_check_eq("T4 N=64 L=1: ERR_STATUS clean", rd & 32'h3F, 0);
      axil_wr(CSR_CTRL, 32'h0);
    end
  endtask

  // ------------------------------------------------------------------
  // T5: read-after-write mix — every port writes address X at one period
  // and reads X back at the next (adjacent periods), 64 ports in parallel
  // ------------------------------------------------------------------
  task automatic test_t5();
    int unsigned a, d;
    logic [31:0] rd;
    begin
      hades_log("--- T5: RAW mix, 64 ports ---");
      calib_done = 1'b1;
      csr_enable(2, {64{1'b1}}, 64);
      for (int k = 0; k < 32; k++) begin
        @(negedge port_clk);
        for (int p = 0; p < N_MAX; p++) begin
          a = 32'h0001_0000 + 32'(k);
          d = 32'h5A00_0000 ^ (32'(p) << 16) ^ 32'(k);
          t_en[p] <= 1'b1; t_we[p] <= 1'b1;
          t_addr[p] <= a; t_wdata[p] <= d;
          hades_mem_write(p, a, d);
        end
        @(negedge port_clk);
        for (int p = 0; p < N_MAX; p++) begin
          a = 32'h0001_0000 + 32'(k);
          t_en[p] <= 1'b1; t_we[p] <= 1'b0; t_addr[p] <= a;
          hades_read_expect(p, pcycle + 1 + cur_lat, a);   // RAW: new data
        end
      end
      @(negedge port_clk);
      for (int p = 0; p < N_MAX; p++) t_en[p] <= 1'b0;
      drain();
      axil_rd(CSR_ERR_STATUS, rd);
      hades_check_eq("T5: ERR_STATUS clean", rd & 32'h3F, 0);
      axil_wr(CSR_CTRL, 32'h0);
    end
  endtask

  // ------------------------------------------------------------------
  // T7: frequency gears 100/500 KHz with T2+T4 subsets at each gear.
  // SYNC: same-source divider switch.  ASYNC: also enables the phase walk
  // (~4.9 deg steps) and +-0.5% slow drift for the whole test.
  // CFG_MIN_PERIOD is relaxed to 590 so -0.5% drift at the 500 KHz gear
  // (period 597) does not trip the over-freq interlock.
  // ------------------------------------------------------------------
  task automatic test_t7();
    logic [31:0] rd;
    int          khz;
    begin
      hades_log("--- T7: gears 100/500 KHz (+ ASYNC phase walk/drift) ---");
      calib_done = 1'b1;
      axil_wr(CSR_CTRL, 32'h0);
      axil_wr(CSR_CFG_MIN_PERIOD, 32'd590);
`ifdef ASYNC
      phase_walk_en = 1'b1;
`endif
      for (int g = 0; g < 2; g++) begin
        khz = (g == 0) ? 100 : 500;
        hades_log($sformatf("T7 gear: %0d KHz", khz));
        port_clk_set_khz(khz);
        repeat (8) @(posedge port_clk);   // freq_mon re-measures the new gear
        csr_enable(2, 64'hF, 4);
        sram_write_burst(0, 32, 32'h6000, 32'h7700_0000);
        sram_write_burst(1, 32, 32'h7000, 32'h0077_0000);
        drain();
        sram_read_burst(0, 32, 32'h6000);
        sram_read_burst(1, 32, 32'h7000);
        drain();
        t4_run(4, 24);
        drain();
        axil_rd(CSR_ERR_STATUS, rd);
        hades_check_eq($sformatf("T7 %0d KHz: ERR_STATUS clean", khz),
                       rd & 32'h3F, 0);
        axil_wr(CSR_CTRL, 32'h0);
      end
`ifdef ASYNC
      phase_walk_en = 1'b0;
      drift         = 0.0;
      port_clk_set_khz(500);
`endif
      axil_wr(CSR_CFG_MIN_PERIOD, 32'(TARGET_PERIOD_500K));   // restore 600
    end
  endtask

  // ------------------------------------------------------------------
  // T9: backdoor channel
  //  A: pre-ENABLE init of all 64 ports through the backdoor, read back
  //     through the target domain
  //  B: backdoor concurrent with live traffic — T2 exactness unaffected,
  //     backdoor data correct; disjoint scratch regions, so no races
  //  C: illegal backdoor address completes with err, no hang, no datapath
  //     error
  // ------------------------------------------------------------------
`ifndef CSR_STATIC
  task automatic test_t9();
    logic [31:0] rd, d, st;
    begin
      hades_log("--- T9: backdoor channel ---");
      calib_done = 1'b1;
      axil_wr(CSR_CTRL, 32'h0);
      csr_default_map();      // phase A runs pre-ENABLE; do not rely on order

      for (int p = 0; p < N_MAX; p++) begin
        for (int w = 0; w < 4; w++) begin
          int unsigned a, dd;
          a  = 32'h0002_0000 + 32'(w);
          dd = 32'hB100_0000 ^ (32'(p) << 8) ^ 32'(w);
          bkp_wr(p, a, dd, st);
          if (st[2]) hades_fail($sformatf("bkp_wr init err port %0d", p));
          hades_mem_write(p, a, dd);
        end
      end

      csr_enable(2, {64{1'b1}}, 64);
      for (int p = 0; p < N_MAX; p++)
        for (int w = 0; w < 4; w++)
          sram_read(p, 32'h0002_0000 + 32'(w));
      drain();

      fork
        begin
          sram_write_burst(0, 48, 32'h0800, 32'h0800_0000);
          sram_read_burst(0, 48, 32'h0800);
        end
        begin
          sram_write_burst(1, 48, 32'h0900, 32'h0900_0000);
          sram_read_burst(1, 48, 32'h0900);
        end
        begin
          for (int p = 4; p < 12; p++) begin
            int unsigned a, dd;
            a  = 32'h0003_0000 + 32'(p);
            dd = 32'hCAFE_0000 ^ 32'(p);
            bkp_wr(p, a, dd, st);
            if (st[2]) hades_fail($sformatf("bkp_wr err port %0d", p));
            hades_mem_write(p, a, dd);
            bkp_rd(p, a, d, st);
            if (st[2]) hades_fail($sformatf("bkp_rd err port %0d", p));
            hades_check_eq($sformatf("bkp readback port %0d", p), d, dd);
          end
        end
      join
      drain();
      axil_rd(CSR_ERR_STATUS, rd);
      hades_check_eq("T9: ERR_STATUS clean (backdoor invisible)", rd & 32'h3F, 0);

      bkp_rd(0, 32'h0040_0000, d, st);   // == PORT_SIZE: illegal
      hades_check_eq("T9: illegal bkp addr -> done+err", st & 32'h7, 32'h6);
      axil_rd(CSR_ERR_STATUS, rd);
      hades_check_eq("T9: backdoor err not a datapath error", rd & 32'h3F, 0);
      axil_wr(CSR_CTRL, 32'h0);
    end
  endtask
`else
  task automatic test_t9();
    logic [31:0] d;
    begin
      hades_log("--- T9 static: pin backdoor ---");
      #10_000;
      // pin backdoor init of ports 0/1 scratch, read back via target domain
      for (int w = 0; w < 4; w++) begin
        bkp_pin(1, 0, 32'h0002_0000 + w, 32'hB100_0000 + w, d);
        hades_mem_write(0, 32'h0002_0000 + w, 32'hB100_0000 + w);
        bkp_pin(1, 1, 32'h0002_1000 + w, 32'hB200_0000 + w, d);
        hades_mem_write(1, 32'h0002_1000 + w, 32'hB200_0000 + w);
      end
      sram_read_burst(0, 4, 32'h0002_0000);
      sram_read_burst(1, 4, 32'h0002_1000);
      drain();
      // concurrent: traffic on port 0 + pin backdoor on port 2
      fork
        begin
          sram_write_burst(0, 32, 32'h0800, 32'h0808_0000);
          sram_read_burst(0, 32, 32'h0800);
        end
        begin
          bkp_pin(1, 2, 32'h0003_0000, 32'hDEAD_5678, d);
          hades_mem_write(2, 32'h0003_0000, 32'hDEAD_5678);
          bkp_pin(0, 2, 32'h0003_0000, 0, d);
          hades_check_eq("static bkp readback", d, 32'hDEAD_5678);
        end
      join
      drain();
      hades_check_eq("T9 static: stat_err clean", stat_err, 0);
    end
  endtask
`endif
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
