RISMicroDevices/HADES-SRAM/(commit log)

2026-10-16 M1: skeleton — pkg/CDC/freq_mon/CSR + CSR_EN variants, SV+DPI-C TB green on VCS and xsim
    - rtl: hades_pkg (cfg_t, CSR map, slot-budget static assert), hades_cdc whitelist
    trio, hades_freq_mon, hades_csr (full 3.3 map, indexed window), hades_port stub,
    hades_sram_top (N-param, CSR_EN=1/0, P_PORT_BASE/SIZE flat vectors)
    - sim: SV harness + DPI-C C++ (no cocotb); VCS primary, xsim secondary
    - tests: T6-basic (217 checks), static smoke (11), param override (16) — all green
    on both simulators; bounds spot-checks (N=128@500K rejected, N=128@100K OK)
    - docs: csr_regmap.md, integration_guide.md skeleton, hades_clocks.xdc template
2026-10-16 M2: full datapath — port CDC + timing shaper + mig_if AXI4 engine + MIG model; T1/T2/T13a green on VCS+xsim
    - rtl: hades_port (Gray-FIFO request channels depth 8, 4 quasi-static response
    slots, per-port toggle event return), hades_timing_shaper (exact L-edge
    release, back-to-back capable, window sentinel), hades_mig_if (FCFS AXI4,
    32-deep in-order track FIFO, sub-word lanes, synth response for illegal
    addresses, stats + err events), hades_freq_mon (4-period average + margin)
    - sim: mig_axi4_model (36-cyc typ latency, row conflicts, refresh/periodic/ZQCS
    occupancy windows), C++ scoreboard (expected memory + due-cycle queues)
    - fixed: grant bubble FSM states (no duplicate AR/AW), r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
    [hades_cdc.sv, hades_csr.sv, hades_freq_mon.sv, hades_mig_if.sv, hades_pkg.sv, hades_port.sv, hades_sram_top.sv, hades_timing_shaper.sv]
2026-10-17 HW spike: VCU1525 MIG example validated on board — calib=1, TG clean via VIO over JTAG
    - fpga/vcu1525/spike/: mig_example_gen.tcl (board-preset MIG DDR4 c0),
    build_example.tcl, add_vio_and_build.tcl (VIO wrap), program_spike.tcl,
    program_and_read.tcl, read_vio.tcl, spike_top.sv, spike_pins.xdc,
    mig_config_dump.txt (resolved MIG config reference for M5)
    - Decisions (user): JTAG = Windows hw_server @ localhost:3121 (WSL2 mirrored
    networking); host control = JTAG-AXI only, no PCIe/XDMA in final design
    - Board facts: part xcvu9p-fsgd2104-2L-e; MIG preset DDR4-2400 RDIMM 72-bit
    ECC, AXI4 512b/34b, ui_clk 300 MHz; UserRefresh_ZQCS knob located
    - Trap found: MIG sys_rst ACTIVE_HIGH vs C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
    [mig_config_dump.txt]
2026-10-17 M3: determinism — refresh/ZQCS scheduler, T3/T11/T14 green on VCS+xsim
    - hades_refresh_sched: window-geared maintenance. Period tick = synced
    port_clk edge; maintenance window = first 150 ui cycles after tick.
    Refresh dues from a free-running CFG_REFRESH_DIV timer (exact long-run
    rate, A6), serviced only inside the window while enabled (<=2/window —
    100 KHz needs ~1.43/period; JEDEC worst spacing 17 us << 9*tREFI);
    debt >= 4 urgency override; free-run while disabled so contents survive
    reconfiguration. ZQCS every CFG_ZQ_DIV target periods, after the
    window's refresh. STAT_REFCNT / STATUS.REFRESH_ACTIVE/ZQ_ACTIVE live
    (CSR + static pins).
    - MIG model: maintenance now reque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
2026-10-17 M4: TDMA arbiter + backdoor — T4/T5/T7/T9/T11 green on VCS+xsim
    - hades_arbiter: static TDMA slot gating in front of mig_if. Eligibility
    latches open at slot_of(i) after the period tick (behind the maintenance
    window) and hold until granted — nominal schedule matches the static
    table exactly; a maintenance/row-conflict stall degrades to in-order
    service inside the budget margin. Gated by enable/port_en/CFG_PORTS.
    - hades_backdoor + mig_if backdoor requester (sel=8'hFF): host content
    load/readout as the lowest-priority requester — served only in the
    maintenance window and idle slots, works while disabled. Illegal
    port/address completes immediately with err and no AXI traff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
    [hades_arbiter.sv, hades_backdoor.sv, hades_csr.sv, hades_mig_if.sv, hades_sram_top.sv, tb_hades_top.sv]
2026-10-18 M5-sim: error paths, reset recovery, coverage gate, long regression — T8/T10/T12/T13 green, line 99.89% FSM 100%
    - mig_if: backend read timeout backstop (768 ui cycles, 5x margin over the
    136-cycle worst legal latency): the tracking head is popped synthetically
    (zeros), ERR_STATUS.bit1 set, per-port stat counted, backdoor reads get
    their own timeout completion. The IP can never hang on a dead backend.
    - BUG FIX (T10 caught it): the 16-bit latency counter wrapped every 65536
    cycles and head_age was computed in 32 bits after the cast, turning a
    pre-wrap timestamp into a huge age -> all in-flight reads falsely timed
    out, and the late-but-alive responses then misrouted into the ne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
    [hades_backdoor.sv, hades_csr.sv, hades_mig_if.sv, hades_port.sv, hades_refresh_sched.sv, hades_sram_top.sv, mig_axi4_model.sv]
2026-10-18 M5-hw built-in tests: SELFTEST_EN per-port on-chip PRBS self-checker (spec 6.2)
    hades_selftest (new, port_clk domain, one per port when SELFTEST_EN=1):
    - self-stimulus: loop of BLK writes -> BLK reads -> drain; pattern is a
    xorshift32 mix of {address, pass counter, PORT_ID} so every port hammers
    a different sequence and a dropped write reads back as last pass's word
    - per-cycle checks at every port_clk edge: rvalid must equal a registered
    shadow of the shaper's own release condition (phase), and read data must
    equal pat() of the request issued exactly L edges earlier (data)
    - issue gated by port_live: port_clk stop / enable drop freezes the
    cycle-accurate contract with the clock (A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
    [hades_csr.sv, hades_mig_if.sv, hades_port.sv, hades_selftest.sv, hades_sram_top.sv, tb_hades_top.sv]
2026-10-23 M5-hw: VCU1525 board acceptance complete — A1–A10 green on SYNC+ASYNC, DoD re-scoped to 56-port load
    Board platform: hades_board_top (MIG C0 DDR4-2400 RDIMM ECC, ui_clk 300 MHz),
    board_clk_gen (fabric gear divider, glitchless BUFGCE gate, toggle-level
    commit consumed at divider wrap), board_ctrl, AXI4-Lite xbar, JTAG-AXI host
    path (no PCIe/XDMA — user decision). build.tcl: one-command SYNC/ASYNC
    (PCIE|MMCM) with A1 gates: WNS >= 0; ASYNC also report_cdc with zero
    unwaived Critical/Warning (reviewed dispositions in cdc_waivers.tcl).
    Timing closure @300 MHz (xcvu9p-2L): iters 1-4 (-2.206 -> +0.002) — mig_if
    PICK/PREP pipeline + fast re-pick (4 cyc/op), registered R/B view, per-ID
    AXI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
    [mig_config_prod.txt]
2026-10-23 HADES-SRAM umbrella rename: hades_* -> hades_sram_* files+modules, HADES backronym fix, repo clean-up
    - HADES = Hybrid Accelerated and Distributed Emulation System; HADES-SRAM
    is the SRAM-emulation sub-project (README, IP description)
    - 15 files renamed hades_* -> hades_sram_* (rtl x11, constraints x2,
    fpga board top, sim DPI C++); legacy constraints/hades_clocks.xdc
    deleted (unreferenced after the sync/async split)
    - 16 modules/packages renamed, incl. the CDC whitelist cells
    (hades_sram_sync2/qs_bus/rst_sync/afifo) and the slot-budget guard
    - bitstream products now hades_sram_vcu1525_<tag>.{bit,ltx}; host default
    HADES_LTX path updated
    - not renamed (not files/modules): DPI C symb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
    [board_clk_gen.sv, hades_sram_arbiter.sv, hades_sram_backdoor.sv, hades_sram_board_top.sv, hades_sram_cdc.sv, hades_sram_csr.sv]
2026-10-23 docs: add clean consumer-facing INTEGRATION_GUIDE.md at repo root
    Standalone integration guide beside README.md — parameters, architecture,
    CDC whitelist, host protocol, MIG checklist, VCU1525 reference build,
    limitations and design headroom — with no working-history/stage references.
    README and AGENTS.md point at it; docs/ working records stay on disk.
2026-10-23 constraints: fix qs_bus delay-bound globs in shipped IP XDCs — anchored '*/u_port/' never matches generate-scope hierarchy (g_ports[i].u_port joins with '.'); bare patterns verified against the route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
2026-10-23 ip: set vendor to rismd.cn (VLNV rismd.cn:hades:hades_sram:1.0) — repackaged, catalog import + OOC synth verified
2026-10-23 ip: add open_ip_gui.tcl — one-shot helper to open the hades_sram IP configurator in the Vivado GUI (scratch project + start_ip_gui; catalog/instance path batch-verified)
2026-10-23 ip: harden open_ip_gui.tcl — self-verify the async customization scope (start_ip_gui returns Tcl-clean even when the scope build fails in a later GUI event: Common 17-190 rdi::create_slave / IP_Flow 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
2026-10-24 v1.1.0: separated configurable SRAM ports
    Add independent per-port widths (1-512), optional byte enables, a friendly Vivado configurator, and static/CSR support. Update integration and CSR documentation, board flows, and hardware IDs.
    Verification: VCS and xsim suites, 99.72% line / 100% FSM coverage, IP packaging and GUI smoke, and SYNC implementation WNS +0.001 ns / hold +0.010 ns. The final ID-updated bitstream was not programmed on-board.
2026-10-26 ip: package generator and documentation payload
    Validate and stage the shared backend, launcher, provider descriptor, integration references, Product Guide, and figures in the generated catalog IP. Keep maintained sources outside the disposable IP directory and preserve the executable launcher.
2026-10-26 v1.1.0: configuration generator and native wizard
    Finalize consumer and maintainer documentation for the shared backend, native HADES-Wizard workflow, full-copy outputs, per-port strict timing constraints, self-test width limits, and ASYNC integration.
    Validated with 103 backend tests, VCS/xsim generated RTL smoke, 23 native core and 20 native UI tests, catalog and generated-IP synthesis, per-port XDC and fake-host CSR checks, RTL elaboration, CLI byte-parity smoke, and PDF verification. Earlier full VCS/xsim regressions and native Windows workflows also passed; no new board regression was run.
